dangdinhkhoi2010/DO-AN-MACH-DIEN-TU-Y-SINH/README.md

# DO-AN-MACH-DIEN-TU-Y-SINH
>> Đồ án môn học Mạch điện tử y sinh - HK1 - Năm học 2025-2026.

Đồ án này nghiên cứu các kỹ thuật thu nhận tín hiệu điện tim - một loại tín hiệu có biên độ cực nhỏ (khoảng 1 mV) và rất dễ bị nhiễu.
Hệ thống thực hiện các nhiệm vụ chính: 
+ Khuếch đại vi sai tín hiệu từ các điện cực dán. 
+ Lọc nhiễu điện lưới 50 Hz bằng bộ lọc Notch Twin-T. 
+ Loại bỏ nhiễu tần số thấp (nhịp thở) và tần số cao (nhiễu cơ EMG).
+ Hiển thị dạng sóng P-QRS-T đặc trưng lên máy hiện sóng DSO138 và Serial Plotter (Arduino IDE, ESP32).
